djurny/rm-mini3-to-esp8266/PCB_V2.0/STL/IR board support 36mm.stl

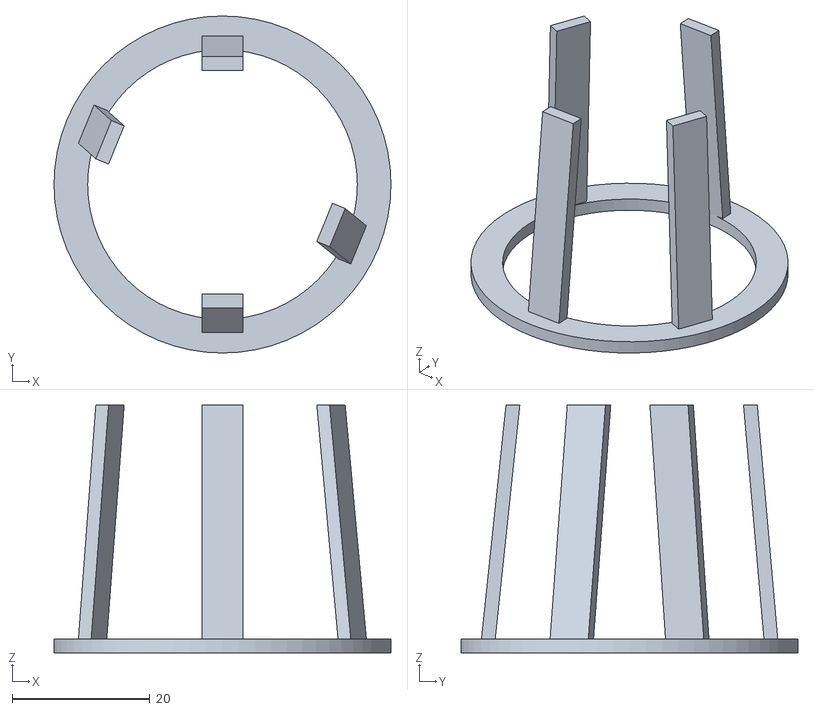
[picture p24: CAD file, 2025-01-19]
PCB_V2.0/STL/IR board support 36mm.stl
49.0 x 49.0 x 36.0
