djurny/rm-mini3-to-esp8266/PCB_V2.0/STL/ESP32 D1 mini tray.stl

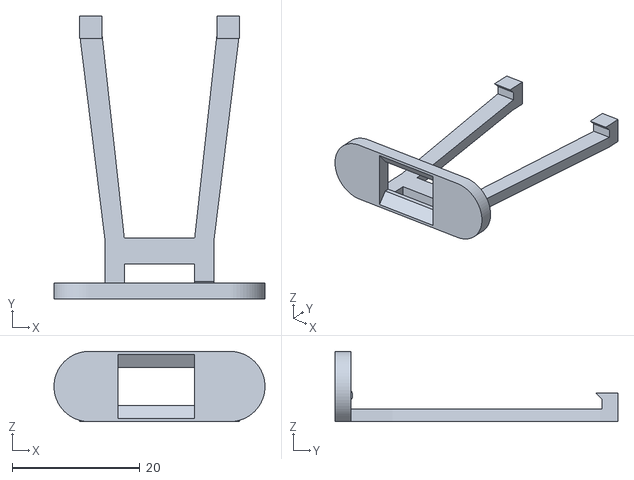
[picture p25: CAD file, 2025-01-19]
PCB_V2.0/STL/ESP32 D1 mini tray.stl
33.0 x 44.2 x 11.0
