djurny/rm-mini3-to-esp8266/PCB_V2.0/STL/IR board holder.stl

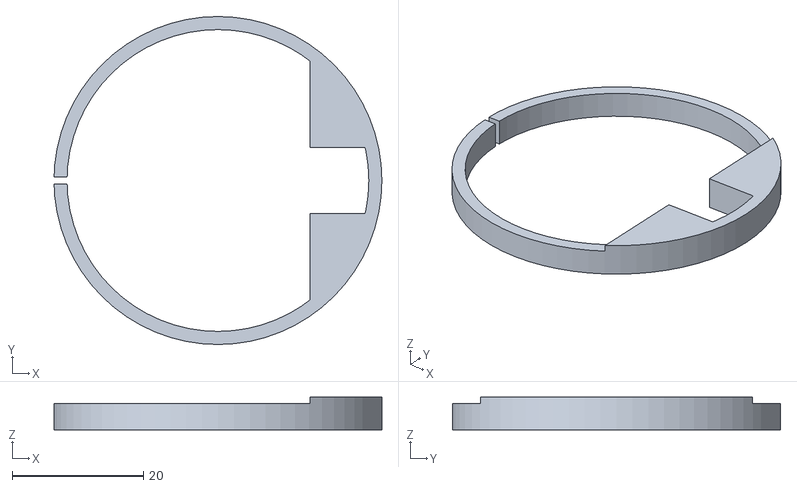
[picture p26: CAD file, 2025-01-19]
PCB_V2.0/STL/IR board holder.stl
50.0 x 50.0 x 5.00
