djurny/rm-mini3-to-esp8266/PCB_V2.0/STL/IR board support 39mm.stl

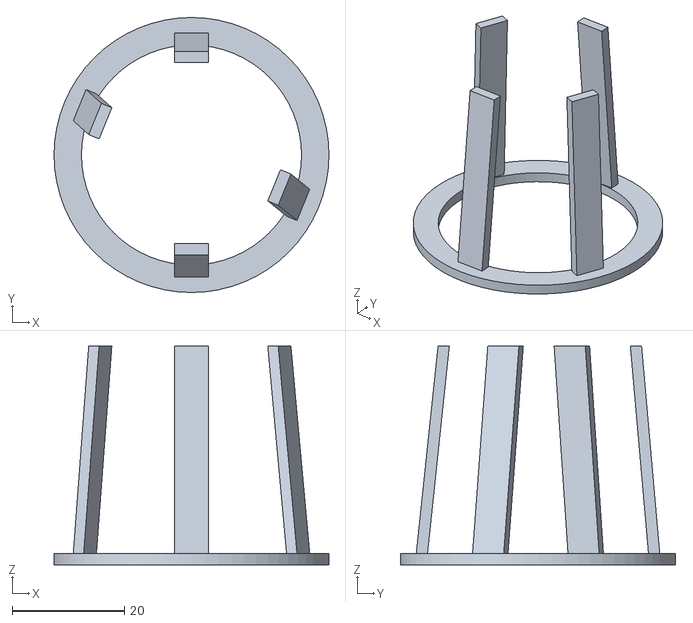
[picture p27: CAD file, 2025-01-19]
PCB_V2.0/STL/IR board support 39mm.stl
49.0 x 49.0 x 39.0
