djurny/rm-mini3-to-esp8266/(commit log)

2025-01-14 Create MINI_IR_N PCB V2.0.md
2025-01-15 Update MINI_IR_N PCB V2.0.md
2025-01-15 Rename MINI_IR_N PCB V2.0.md to PCB_V2.0/README.md
2025-01-15 Rename pics/01 open up the top.jpg to PCB_V2.0/Pictures/01 open up the top.jpg
2025-01-15 Rename pics/02 remove pcbs.jpg to PCB_V2.0/Pictures/02 remove pcbs.jpg
2025-01-15 Rename pics/03 remove bottom weight.jpg to PCB_V2.0/Pictures/03 remove bottom weight.jpg
2025-01-15 Rename pics/04 bottom weight removed.jpg to PCB_V2.0/Pictures/04 bottom weight removed.jpg
2025-01-15 Rename pics/05a top view ir pcb.jpg to PCB_V2.0/Pictures/05a top view ir pcb.jpg
2025-01-15 Rename pics/05b bottom view ir pcb.jpg to PCB_V2.0/Pictures/05b bottom view ir pcb.jpg
2025-01-15 Rename pics/06a bottom view ir pcb.jpg to PCB_V2.0/Pictures/06a bottom view ir pcb.jpg
2025-01-15 Rename pics/06b top view ir pcb.jpg to PCB_V2.0/Pictures/06b top view ir pcb.jpg
2025-01-15 Rename pics/06c bottom control pcb.jpg to PCB_V2.0/Pictures/06c bottom control pcb.jpg
2025-01-15 Rename pics/07 bottom ir pcb pad-out.jpg to PCB_V2.0/Pictures/07 bottom ir pcb pad-out.jpg
2025-01-15 Rename pics/08 test setup esp8266.jpg to PCB_V2.0/Pictures/08 test setup esp8266.jpg
2025-01-19 added STLs
    [ESP32 D1 mini tray.stl, IR board holder.stl, IR board support 36mm.stl, IR board support 39mm.stl]
